loved642/Speed-sensing-vibration-monitoring-terminal/THIRD_PARTY_NOTICES.md

# Third-party notices

- TUL Corporation PYNQ-Z2 board preset and master pin information: board/pynq_z2_preset.tcl, board/pynq_z2_master.xdc, derivative pin mapping in board/overlay_pins.xdc. Attribution retained; this project does not relicense third-party board definitions as original work. Consult the TUL/PYNQ source license for redistribution terms.
- AMD Vivado processing_system7 and generated bit/hwh: generated platform artifacts, not newly authored RTL of this project. Vivado is installed separately under AMD terms.
- PYNQ, NumPy, Matplotlib and Python are external dependencies under their own licenses, not vendored here.
- Archived measurement data were produced by this project. AI assistance was used for implementation, diagnosis, documentation and experiments; human board operation and real measurements are distinguished from simulation.
