loved642/Speed-sensing-vibration-monitoring-terminal/data/analysis/rms_comparison.png

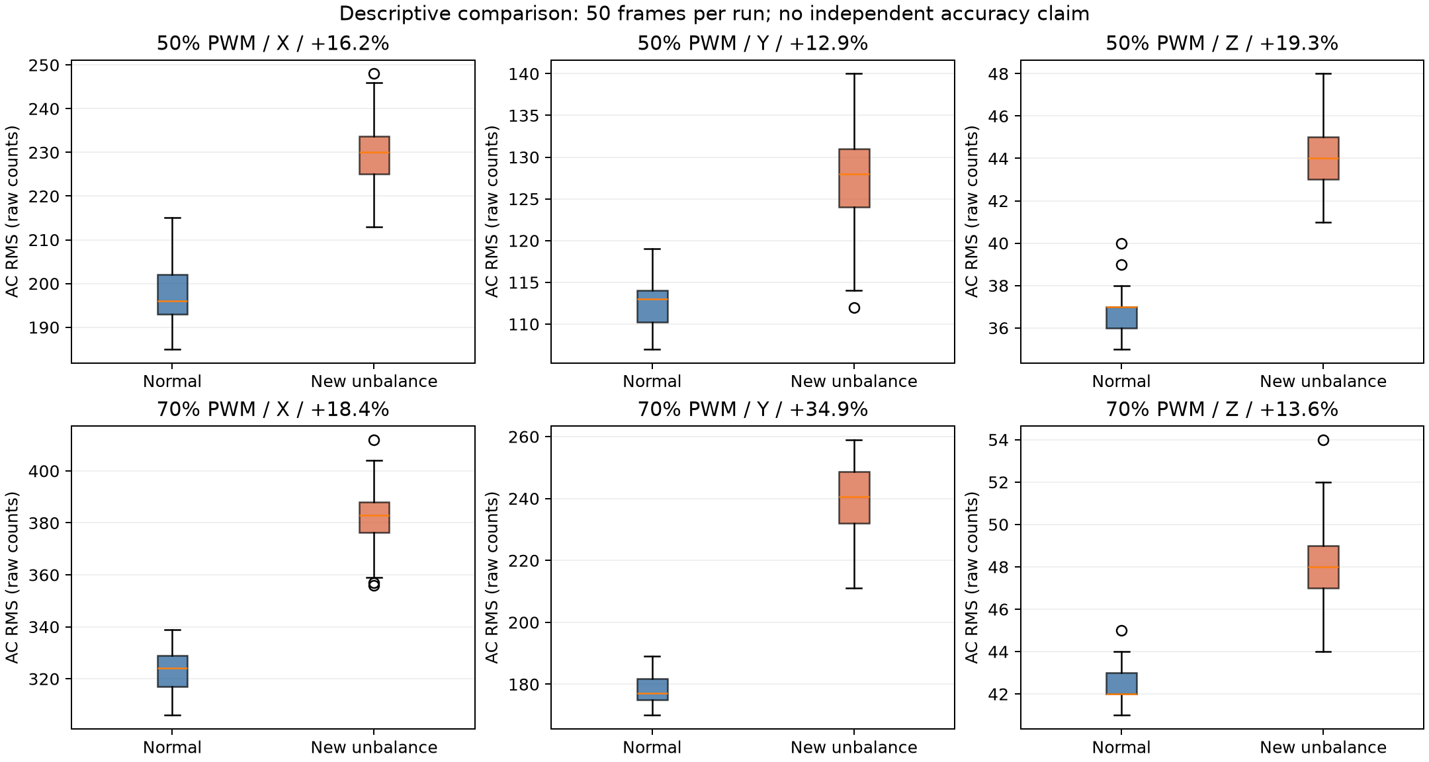
data/analysis/rms_comparison.png
