loved642/Speed-sensing-vibration-monitoring-terminal/report/rms_comparison.png

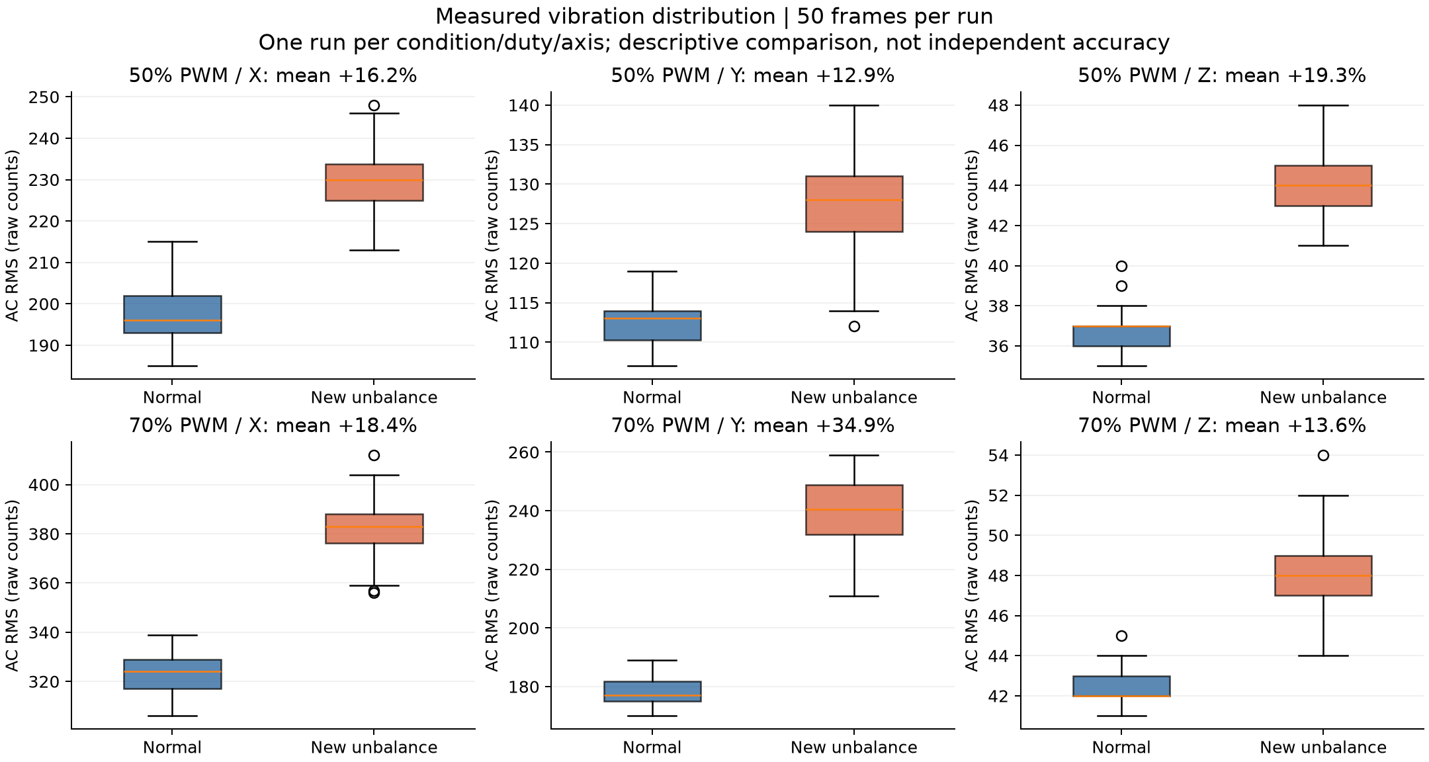
report/rms_comparison.png
