loved642/Speed-sensing-vibration-monitoring-terminal/report/rms_traces.png

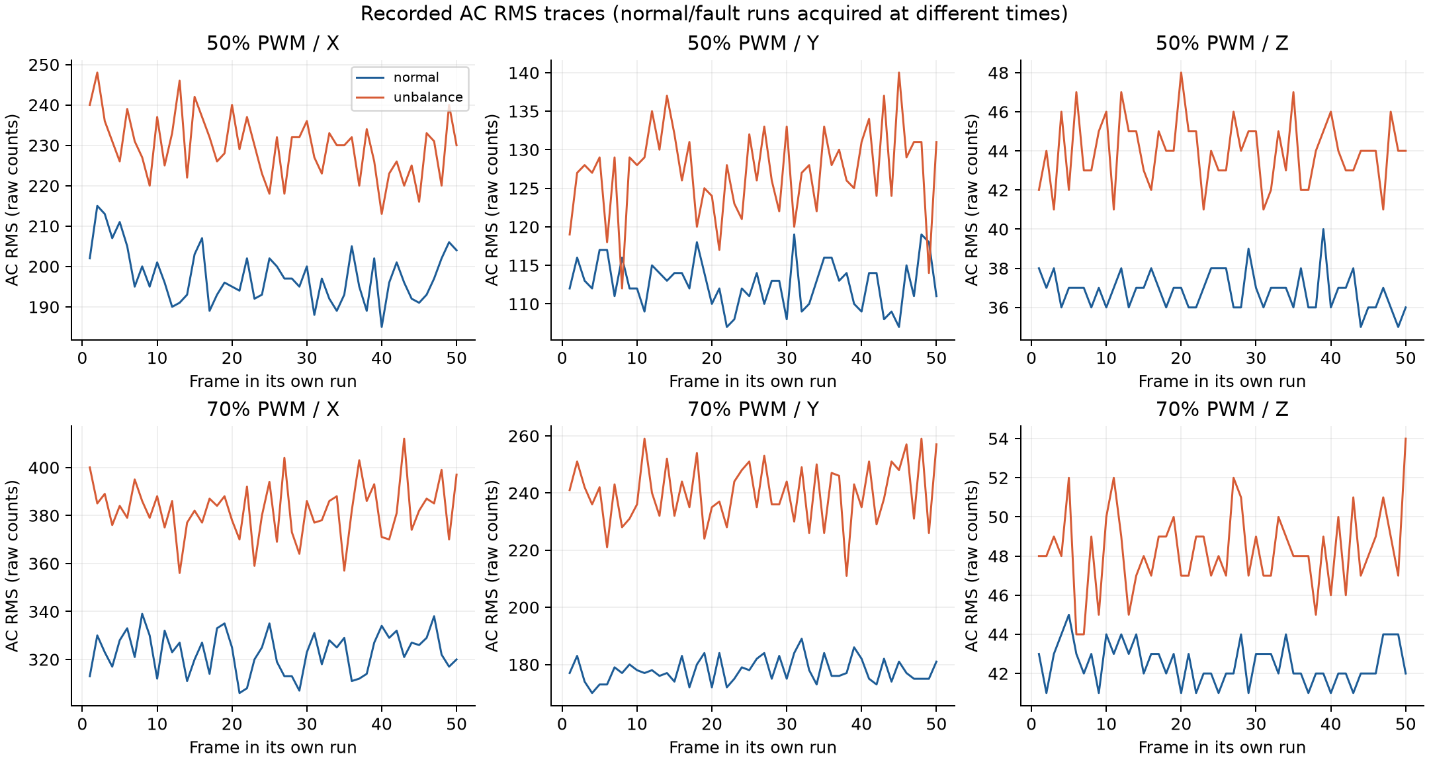
report/rms_traces.png
