loved642/Speed-sensing-vibration-monitoring-terminal/report/system_architecture.png

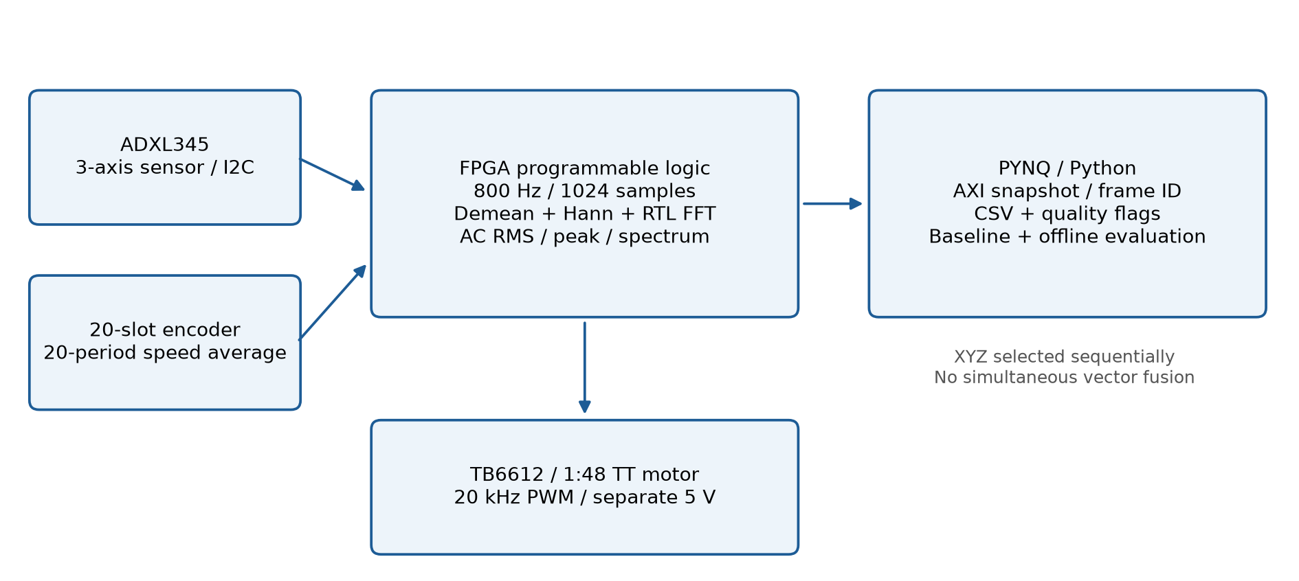
report/system_architecture.png
