loved642/Speed-sensing-vibration-monitoring-terminal/report/history/program_repair_20261019.md

# 程序修复与离线验证记录（2026-10-19）

## 状态

已修改工程：C:/Users/MECHREVO/Documents/OPENCODE/speed_aware_vibration_monitor。
开发板不在现场；本次不包含实板传感器、测速、电机或异常识别验证。
最终位流构建通过，已导出本版配对 board/vib_monitor/vib.bit 与 vib.hwh。以下是离线结果，不代表实板通过。

## 程序修改

| 范围 | 修改及目的 |
|---|---|
| FFT | 位反转输入、自然顺序输出512频点，26位Q8复数计算，去均值/Hann，舍入/溢出，正确完成脉冲；去均值、窗乘法、舍入分拍以收敛时序 |
| 帧缓冲 | 完整帧sum/min/max；禁用、换轴、传感器失去就绪后丢半帧；时间特征有效脉冲仅一个周期 |
| 测速 | 真正的连续电平过滤、首沿建立起点、最短周期、停转超时清零，1×/2×分别舍入 |
| 顶层/AXI | 独立AW/W握手与背压；整帧特征快照、频谱双bank、FRAME_ID、质量标志和丢帧计数；内部运算单元使用同步清除 |
| 电机 | PmodB引出20kHz PWM/方向/STBY，默认停机，控制切换留空档，1秒心跳超时停机，超时后须显式重新使能 |
| Python驱动 | 校验固件版本；等待新帧号；读前后核对同一帧；有符号均值，诊断与实际采样配置；真实PWM和心跳API |
| 基线 | 低速优先broadband交流RMS/RPM+峰值比；orders另需可分频带；缺基线/无效帧返回未知；量化/相对方差下限 |
| 采集 | 一次命令只对应一个显式物理工况；分步调占空比、稳态帧丢弃、逐行落盘、唯一run_id、完整质量字段、异常退出停机 |
| 评估 | 独立train/validation/test会话，拒绝run_id交叉/配置混用；独立验证定阈值；报告未知覆盖率与共同有效帧比较，不编造报警延迟 |
| 构建/文档 | 默认run_all构建可部署overlay；保留DRC；验证ROM、IOBUF、setup/hold后才替换配对bit/hwh；更新旧SPI诊断说明 |

## 验证证据

执行 sim/run_sim.ps1，输出保存在 sim/regression_20261019.txt。

- I2C：6271项检查通过，涵盖引脚级START/重复START、配置、六字节顺序、ACK/NACK、错误地址、缺席传感器、错误ID、总线卡死/恢复、时钟拉伸和禁用重启；使用厂商IOBUF模型。
- FFT：12组输入通过，每帧512个完整自然频点、一次完成；与NumPy对照6144个正频点，最大幅值误差约0.116码。覆盖DC、奇偶频点、低幅双音、非整数频率、噪声。
- 测速：首沿、毛刺拒绝、RPM、独立舍入得到bin6/13、停转/重启通过。
- 顶层：AXI地址/数据独立到达、读写背压、字节写、四帧快照、正负DC去除、完整频谱能量一致、半帧重启、PWM占空比/方向留空档/心跳超时及重新使能通过，另覆盖传感器掉线后重新攒完整帧。
- Python：5组模拟测试通过，涵盖帧一致性、未知与质量过滤、会话隔离/覆盖率、真实新帧等待、采集标签/稳态丢弃/异常停机。

顶层测试通过强制传感器输出注入样本来验证帧→FFT→快照→AXI，不是传感器I2C模型到PS Linux的全系统仿真。Python使用模拟MMIO，不是板上驱动实测。

## 构建检查

首轮100MHz实现暴露了组合稳态除法、去均值/加窗乘法及局部异步复位的时序问题；导出保护拒绝替换旧位流。之后已拆分运算、同步清除并将RPM到频点换算再分拍；最终100MHz实现通过：WNS +0.804 ns，TNS 0.000 ns；WHS +0.073 ns，THS 0.000 ns。失败时序报告保存在 report/timing_before_pipeline_20261019.rpt，不能作最终验证结果。

## 使用与边界

操作示例见README的Verify及Frame snapshots章节。完整寄存器/接线及算法说明见design_report.md。TB6612必须按新增PmodB引脚接线；占空比不是闭环RPM命令。

默认800Hz/1024点，窗长1.28秒；1:90是减速比，未测得实际RPM。低速1×/2×可能重叠，因此默认只用broadband分转速基线；orders会拒绝不可分频带。降低FS须同步修改ADXL345输出率和PL配置并重建，实际采样、混叠、噪声、稳态及故障可分性仍须实测。

I2C仍按本地定时轮询，没有DATA_READY同步，无法仅凭读取成功证明连续独立转换。实板下一步先验E5/采样进度、实际每圈脉冲、静止/运行信噪比和电机控制，再进行独立实验采集。

修改前源码备份：C:/Users/MECHREVO/Documents/ChatGPT/嵌入式竞赛/backups/program-before-repair-20261019-185014.zip。

最终资源：Slice LUTs=5062, Slice Registers=3561, Block RAM Tile=3, DSPs=16。FFT工作RAM本次映射到分布式RAM，占用已计入LUT；不是全部RAM都映射为BRAM。

导出校验：bit/hwh分别与同次实现的原始输出SHA-256一致；HWH中的100MHz、800Hz、1024点、20槽及AXI基址0x40000000一致，测速为输入，四路电机信号为输出；两根I2C线最终各有一个IOBUF。校验清单见build_manifest_20261019.json。

新增PYNQ3启动入口board/run_measure.sh；Python与PowerShell脚本检查、Bash语法检查通过。部署包为vib_deploy_20261019.zip，解压到板子/home/xilinx/vib并按包内使用说明操作。
