loved642/Speed-sensing-vibration-monitoring-terminal/report/history/speed_average_20261029.md

# 2026-10-29：测速一圈周期平均与稳态诊断

## 实板问题证据（用户运行后提供）

- 1:48 TT电机、正常轮、X轴，50%：20帧平均80.57 RPM，帧内极差/均值平均9.8%，范围6.9%至14.0%。
- 同一配置70%：20帧平均115.74 RPM，帧内极差/均值平均10.7%，范围8.9%至12.3%。
- 两组I²C最大累计错误、处理丢帧、主机漏读均为0；全部frame_flags=0x03，完整且测速有效但未达到稳态位。
- 此前算法直接对相邻槽上升沿的周期取倒数，帧内最大/最小因此包含槽距、偏摆及真实圈内速度变化。仅凭现有CSV不能确定各项误差来源。

## 本次修改

- `src/speed_capture.v`：默认AVG_PERIODS=SLOTS=20，用环形缓冲维护最近20个测得的槽周期之和，每个新有效槽更新一次RPM。
- 换算为 `rpm_x100 = 6000 * FCLK_HZ * AVG_PERIODS / (sum_periods * SLOTS)`；不对单槽RPM的倒数做算术平均。
- 首沿建立计时，收满20个周期后才发布有效平均速度。1秒无有效上升沿清除RPM、有效标志、窗口计数与和，重启后重新收满窗口。
- 0x4C仍发布最近一个原始槽周期；0xA0/A4为48位当前窗口周期和，0xA8为窗口深度，0xAC为已收周期数量。
- `src/vib_top.v`固件版本改为0x00020002。稳态公式保持 `(frame_max-frame_min)*20 <= frame_mean`，但速度输入现在是一圈滑动平均。
- `board/vib_monitor.py`兼容0x00020001和0x00020002；采集CSV保留实际版本，现有评估逻辑拒绝混用固件配置。
- `board/run_measure.py`在等待稳态时逐帧打印RPM、最小/最大、极差比例、flags与累计I²C计数，不再只在超时后报错。
- 增加`test_speed_average.py`和`run_speed_average.sh`。默认不启动电机；显式`--duty 0.70`才启动，8帧后通过finally关闭电机和采集。

## 验证与构建

- I²C引脚级回归：6271检查PASS。
- FFT：12帧、6144个正频点与NumPy对比PASS。
- 测速：原始单槽模式、滤毛刺、首沿、20槽窗口填充、交替9000/11000周期槽距误差消除、真实速度阶跃、停转清历史、重启后重新填满均PASS。
- AXI/快照/采集恢复/PWM/心跳回归PASS；Python主机回归7项PASS（含两版本兼容、未知版本拒绝、稳态超时打印与停止清理）。
- Vivado 2025.2 PS+PL构建成功，I²C两路真实IOBUF校验通过；实现DRC 0 Errors。
- 时序：100 MHz，WNS=0.903 ns，TNS=0，WHS=0.008 ns，THS=0。
- 实现资源：LUT 5264，寄存器4291，BRAM 3，DSP 16。
- 构建日志：`build/speed_average_build_20261029.log`；报告：`report/overlay_timing.rpt`与`overlay_utilization.rpt`。
- 修改前备份：`report/backup_before_speed_average_20261029.zip`（源文件、脚本和旧bit/hwh）。

## 部署包

电脑目录：`C:\Users\MECHREVO\Desktop\嵌入式竞赛\pynq-speed-average-20261029`，同目录有zip副本。

包内`install.sh`先校验SHA-256，备份将替换的旧文件，替换匹配bit/hwh/驱动/采集程序，保留既有logs。自动系统检查不启用电机和采集。安装逻辑已在电脑临时文件系统中模拟验证：备份旧文件、新文件一致、原logs保留；并未在开发板上执行。安装时若自动系统检查失败，应停止继续试转，按输出排查或恢复备份。

## 尚未完成的实板验收及测量边界

1. 初版更新包已由用户安装上板，version=0x00020002、AVG_PERIODS=20及SHA-256检查通过。正常轮70%试8帧：首帧含窗口填充过渡，后7帧flags=0x07、帧RPM约112、极差0.4%～0.9%，I²C错误和丢帧均为0。这仅支持该次实板平均测速及稳态筛选工作，不代表异常识别或RPM标定验收。
2. 新RPM为最近一圈平均速度，真实圈内速度变化同样会被平均。80 RPM一圈约0.75秒，115 RPM约0.52秒；响应延迟和频率特性应在最终报告说明，不能说瞬时速度已经稳定或测速精度提高到某百分比。
3. 平均不会解决接触不良、误/漏脉冲、光电阈值异常或真实长期加减速；若新固件仍不稳，应继续量测，不盲目放宽稳态门限。
4. 独立RPM标定、实际采样转换节奏、分转速基线、跨运行泛化与报警延迟仍待实验。默认低速1x/2x阶次带分辨率限制没有改变。

## 上板后修正：诊断单槽显示的单位

用户8帧输出中rawSlotRPM_now约11000，而RPM约112。诊断Python脚本错误地使用6000*FCLK/(period*SLOTS)，输出了RPM×100却标为RPM；正确公式应使用60。已修正本地脚本并新增300 RPM已知周期的输出回归，主机共8项测试通过；更新了桌面文件夹/zip中的脚本和哈希清单。该错误只影响额外的单槽诊断显示，未进入FPGA、稳态标志或run_measure的CSV RPM。用户板上最初安装的诊断脚本仍是旧显示版本，不应直接比较其rawSlotRPM_now与RPM；重新安装本地更新包后才会修正该字段。未修改或重新生成bit/hwh。
